dlavila/performer-hardware/sequencer.kicad_pcb

## KiCad design sequencer.kicad_pcb (2020-09-04)

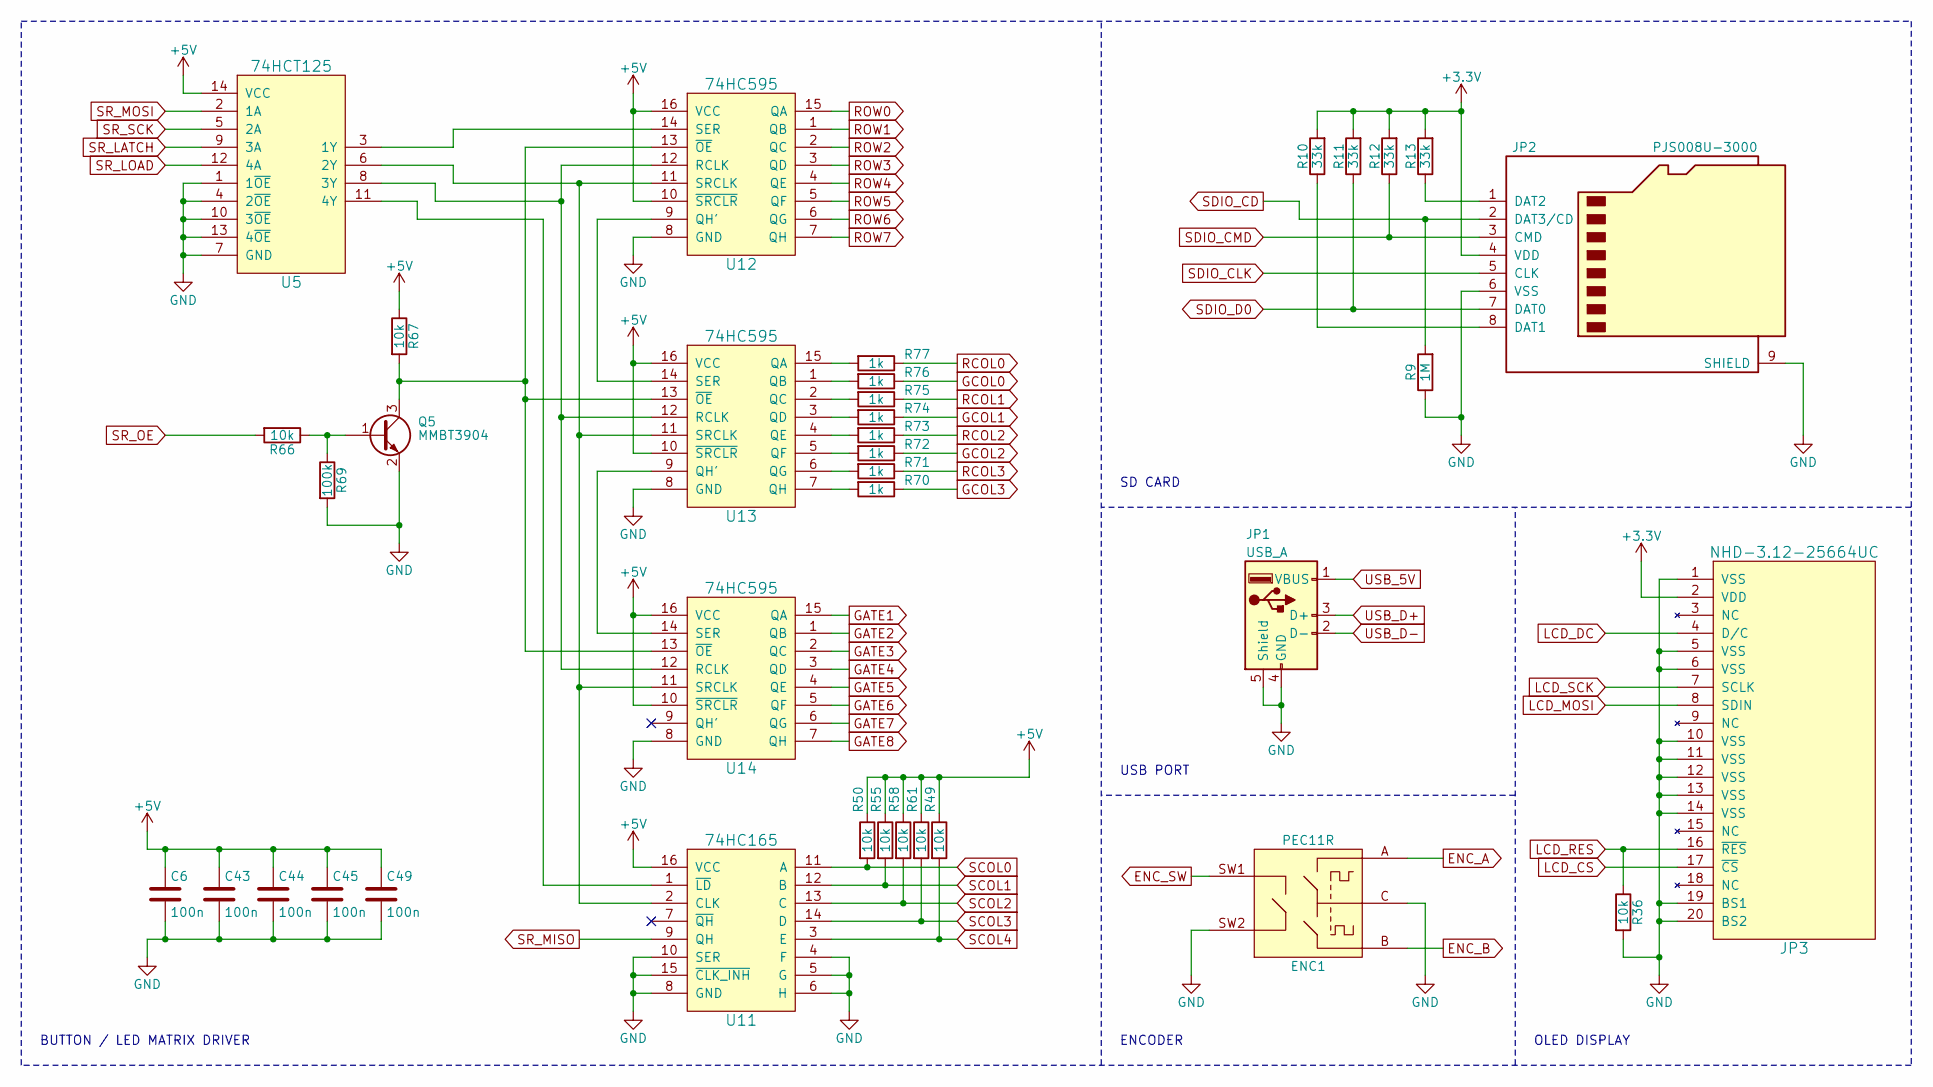
[picture p1: schematic global.sch, PER|FORMER eurorack sequencer]

Parts:
C6, C43, C44, C45, C49: 100n; C_0603
ENC1: PEC11R; ALPS_STEC12E08
JP1: USB_A; Kycon_USB_KUSBVLPX-AS1N
JP2: PJS008U-3000; PJS008U-3000-0
JP3: NHD-3.12-25664UC
Q5: MMBT3904; SOT-23
R9: 1M; R_0603
R10, R11, R12, R13: 33k; R_0603
R36, R49, R50, R55, R58, R61, R66, R67: 10k; R_0603
R69: 100k; R_0603
R70, R71, R72, R73, R74, R75, R76, R77: 1k; R_0603
U5: 74HCT125; SOIC-14_3.9x8.7mm_P1.27mm
U11: 74HC165; SOIC-16
U12, U13, U14: 74HC595; SOIC-16

Connections:
ENC_A: ENC1.A; also elsewhere on the board
ENC_B: ENC1.B; also elsewhere on the board
ENC_SW: ENC1.SW1; also elsewhere on the board
GATE1: U14.15 (QA); also elsewhere on the board
GATE2: U14.1 (QB); also elsewhere on the board
GATE3: U14.2 (QC); also elsewhere on the board
GATE4: U14.3 (QD); also elsewhere on the board
GATE5: U14.4 (QE); also elsewhere on the board
GATE6: U14.5 (QF); also elsewhere on the board
GATE7: U14.6 (QG); also elsewhere on the board
GATE8: U14.7 (QH); also elsewhere on the board
GCOL0: R76.1; also elsewhere on the board
GCOL1: R74.1; also elsewhere on the board
GCOL2: R72.1; also elsewhere on the board
GCOL3: R70.1; also elsewhere on the board
LCD_CS: JP3.17 (~CS); also elsewhere on the board
LCD_DC: JP3.4 (D/C); also elsewhere on the board
LCD_MOSI: JP3.8 (SDIN); also elsewhere on the board
LCD_RES: JP3.16 (~RES), R36.1; also elsewhere on the board
LCD_SCK: JP3.7 (SCLK); also elsewhere on the board
unnamed: JP2.1 (DAT2), R13.1
unnamed: JP2.8 (DAT1), R10.1
unnamed: Q5.1 (B), R66.1, R69.1
unnamed: Q5.3 (C), R67.2, U12.13 (~OE~), U13.13 (~OE~), U14.13 (~OE~)
unnamed: R70.2, U13.7 (QH)
unnamed: R71.2, U13.6 (QG)
unnamed: R72.2, U13.5 (QF)
unnamed: R73.2, U13.4 (QE)
unnamed: R74.2, U13.3 (QD)
unnamed: R75.2, U13.2 (QC)
unnamed: R76.2, U13.1 (QB)
unnamed: R77.2, U13.15 (QA)
unnamed: U5.11 (4Y), U11.1 (~LD~)
unnamed: U5.6 (2Y), U11.2 (CLK), U12.11 (SRCLK), U13.11 (SRCLK), U14.11 (SRCLK)
unnamed: U12.9 (QH'), U13.14 (SER)
unnamed: U5.8 (3Y), U12.12 (RCLK), U13.12 (RCLK), U14.12 (RCLK)
unnamed: U5.3 (1Y), U12.14 (SER)
unnamed: U13.9 (QH'), U14.14 (SER)
RCOL0: R77.1; also elsewhere on the board
RCOL1: R75.1; also elsewhere on the board
RCOL2: R73.1; also elsewhere on the board
RCOL3: R71.1; also elsewhere on the board
ROW0: U12.15 (QA); also elsewhere on the board
ROW1: U12.1 (QB); also elsewhere on the board
ROW2: U12.2 (QC); also elsewhere on the board
ROW3: U12.3 (QD); also elsewhere on the board
ROW4: U12.4 (QE); also elsewhere on the board
ROW5: U12.5 (QF); also elsewhere on the board
ROW6: U12.6 (QG); also elsewhere on the board
ROW7: U12.7 (QH); also elsewhere on the board
SCOL0: R50.2, U11.11 (A); also elsewhere on the board
SCOL1: R55.2, U11.12 (B); also elsewhere on the board
SCOL2: R58.2, U11.13 (C); also elsewhere on the board
SCOL3: R61.2, U11.14 (D); also elsewhere on the board
SCOL4: R49.2, U11.3 (E); also elsewhere on the board
SDIO_CD: JP2.2 (DAT3/CD), R9.2; also elsewhere on the board
SDIO_CLK: JP2.5 (CLK); also elsewhere on the board
SDIO_CMD: JP2.3 (CMD), R12.1; also elsewhere on the board
SDIO_D0: JP2.7 (DAT0), R11.1; also elsewhere on the board
SR_LATCH: U5.9 (3A); also elsewhere on the board
SR_LOAD: U5.12 (4A); also elsewhere on the board
SR_MISO: U11.9 (QH); also elsewhere on the board
SR_MOSI: U5.2 (1A); also elsewhere on the board
SR_OE: R66.2; also elsewhere on the board
SR_SCK: U5.5 (2A); also elsewhere on the board
USB_5V: JP1.1 (VBUS); also elsewhere on the board
USB_D+: JP1.3 (D+); also elsewhere on the board
USB_D-: JP1.2 (D-); also elsewhere on the board

Notes on the sheet:
BUTTON / LED MATRIX DRIVER
SD CARD
OLED DISPLAY
ENCODER
USB PORT

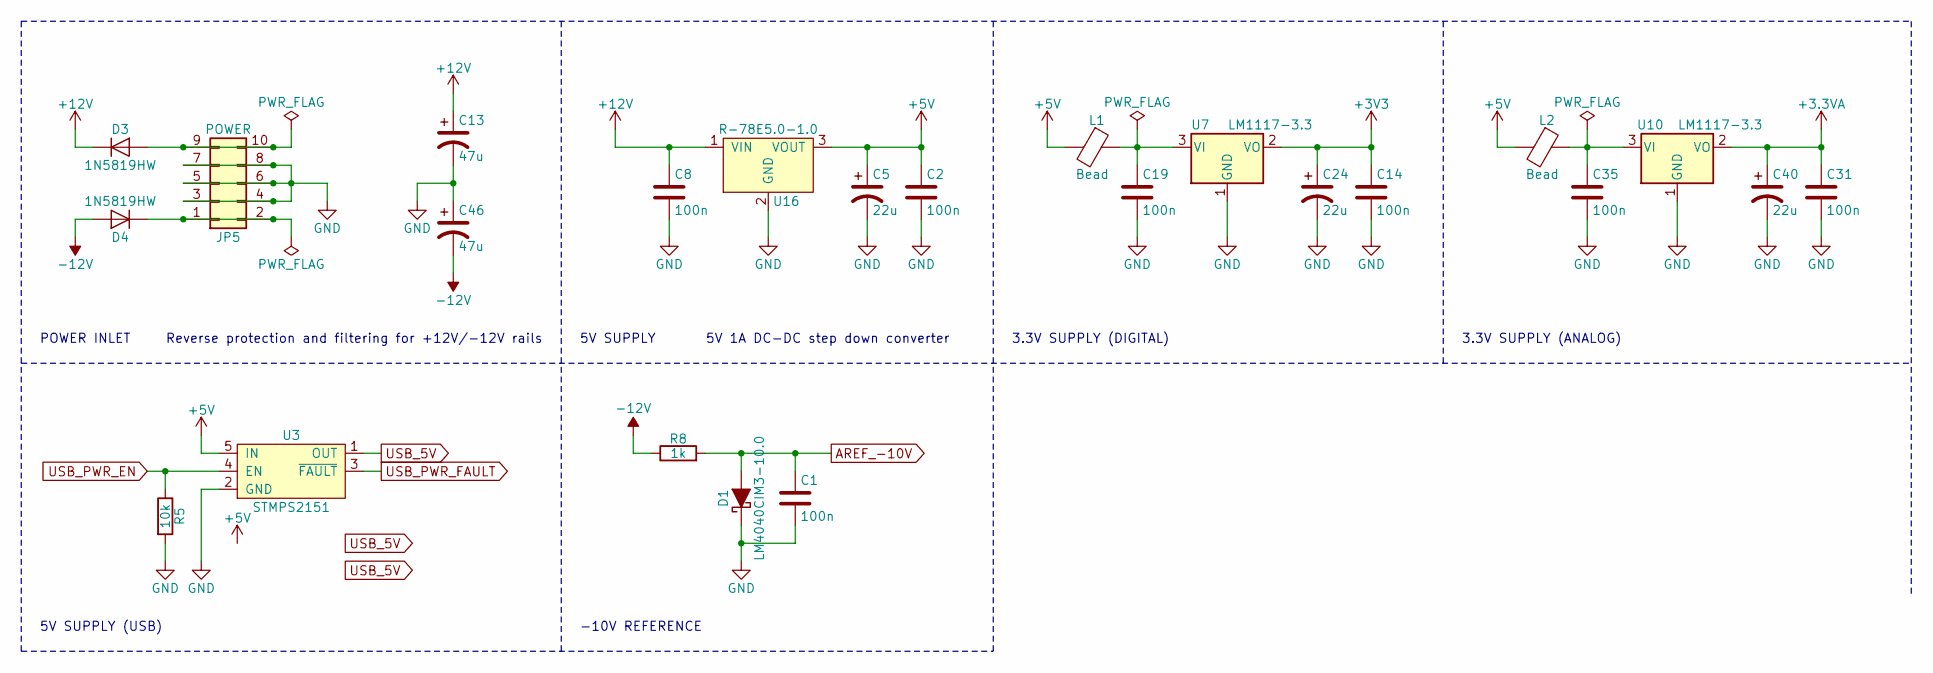
[picture p2: schematic power.sch, PER|FORMER eurorack sequencer]

Parts:
C1, C2, C8, C14, C19, C31, C35: 100n; C_0603
C5, C24, C40: 22u; CP_Elec_5x5.8
C13, C46: 47u; CP_Elec_6.3x5.7
D1: LM4040CIM3-10.0; SOT-23
D3, D4: 1N5819HW; D_SOD-123
JP5: POWER; PinHeader_2x05_P2.54mm_Vertical
L1, L2: Bead; R_0603
R5: 10k; R_0603
R8: 1k; R_0603
U3: STMPS2151; TSSOP-8_4.4x3mm_P0.65mm
U7, U10: LM1117-3.3; SOT-223-3_TabPin2
U16: R-78E5.0-1.0; R-78E-1.0

Connections:
+3.3VA: C31.1, C40.1, U10.2 (VO); also elsewhere on the board
+12V: C8.1, C13.1, D3.1 (K), U16.1 (VIN); also elsewhere on the board
-12V: C46.2, D4.2 (A), R8.1; also elsewhere on the board
AREF_-10V: C1.1, D1.2 (A), R8.2; also elsewhere on the board
unnamed: C19.1, L1.1, U7.3 (VI)
unnamed: C35.1, L2.1, U10.3 (VI)
unnamed: D3.2 (A), JP5.9, JP5.10
unnamed: D4.1 (K), JP5.1, JP5.2
USB_5V: U3.6, U3.7, U3.8; also elsewhere on the board
USB_PWR_EN: R5.1, U3.4 (EN); also elsewhere on the board

Notes on the sheet:
POWER INLET
Reverse protection and filtering for +12V/-12V rails
5V SUPPLY
5V 1A DC-DC step down converter
3.3V SUPPLY (DIGITAL)
3.3V SUPPLY (ANALOG)
5V SUPPLY (USB)
-10V REFERENCE

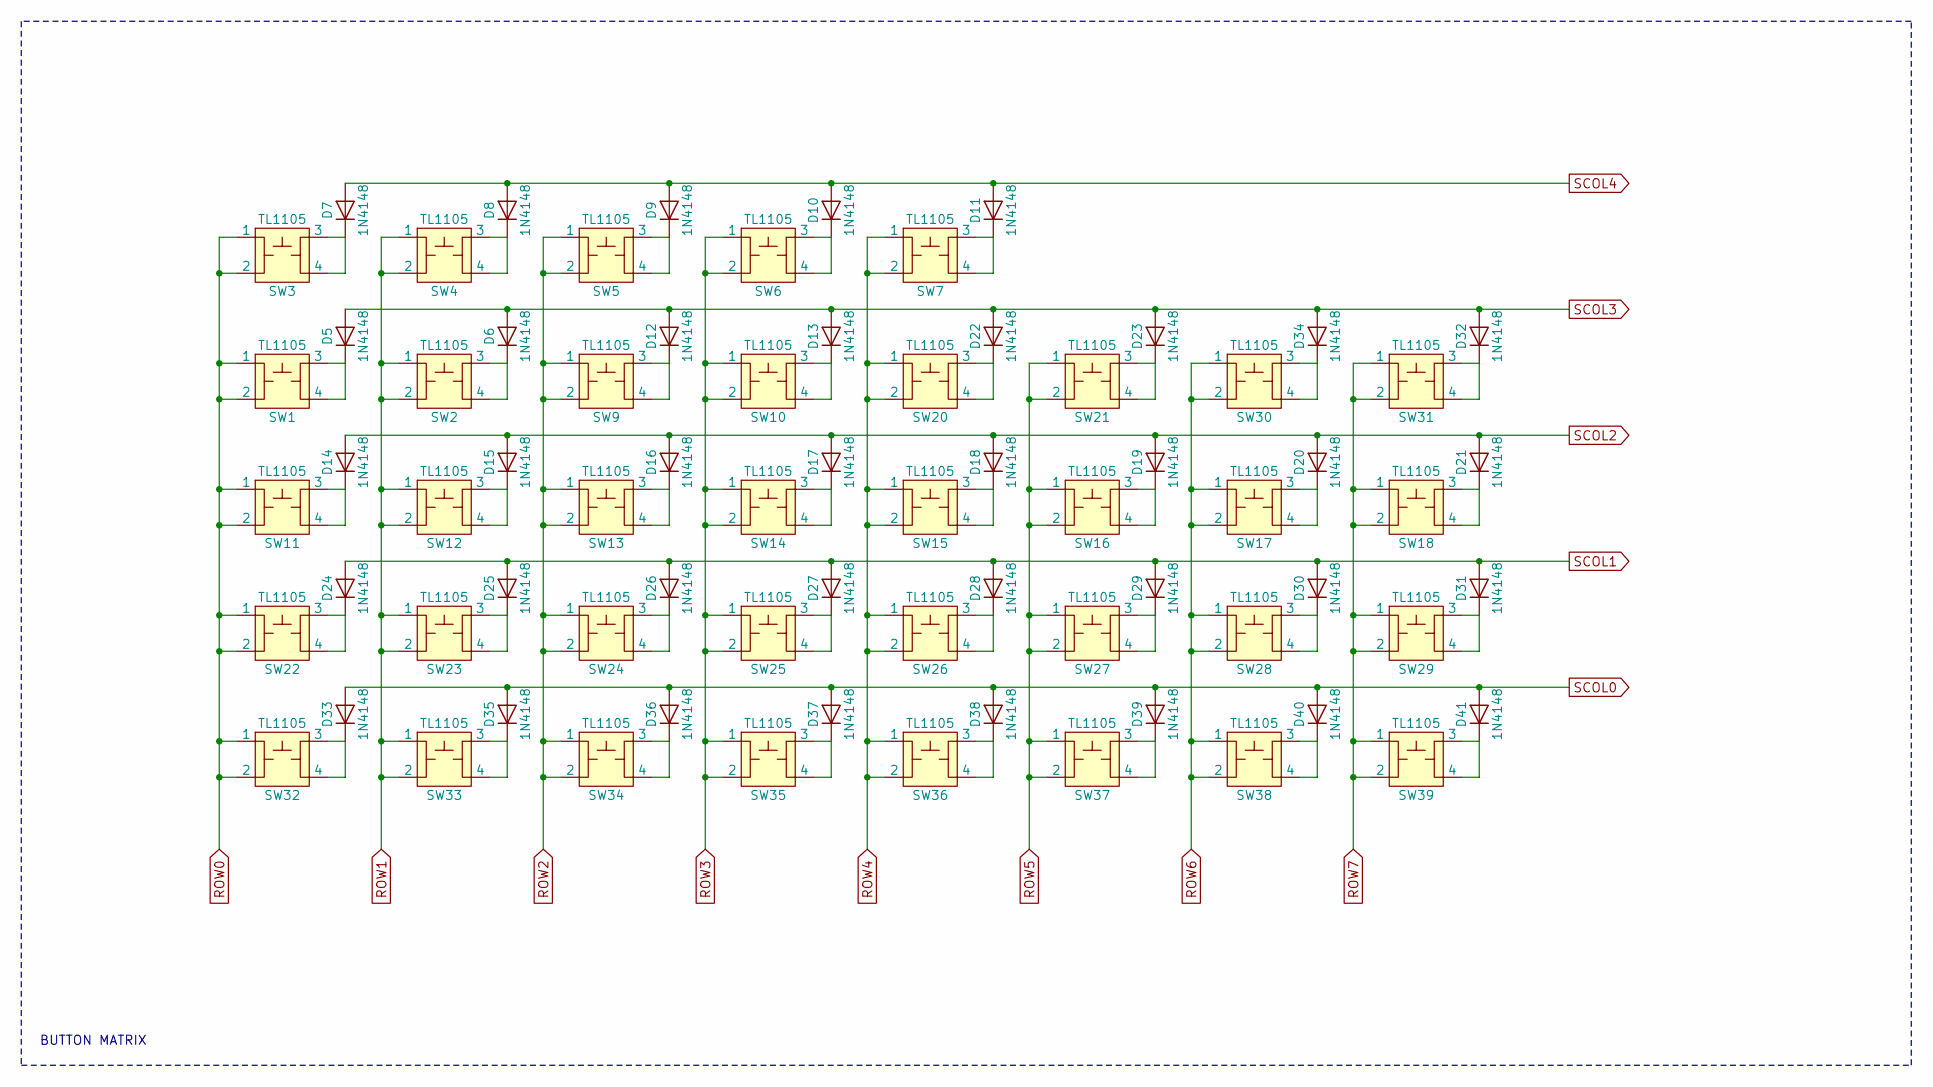
[picture p3: schematic button-matrix.sch, PER|FORMER eurorack sequencer]

Parts:
D5, D6, D7, D8, D9, D10, D11, D12, D13, D14, D15, D16, D17, D18, D19, D20, D21, D22, D23, D24, D25, D26, D27, D28, D29, D30, D31, D32, D33, D34, D35, D36, D37, D38, D39, D40, D41: 1N4148; D_SOD-123
SW1, SW2, SW3, SW4, SW5, SW6, SW7, SW9, SW10, SW11, SW12, SW13, SW14, SW15, SW16, SW17, SW18, SW20, SW21, SW22, SW23, SW24, SW25, SW26, SW27, SW28, SW29, SW30, SW31, SW32, SW33, SW34, SW35, SW36, SW37, SW38, SW39: TL1105; TL1105T

Connections:
unnamed: D5.1 (K), SW1.3, SW1.4
unnamed: D6.1 (K), SW2.3, SW2.4
unnamed: D7.1 (K), SW3.3, SW3.4
unnamed: D8.1 (K), SW4.3, SW4.4
unnamed: D9.1 (K), SW5.3, SW5.4
unnamed: D10.1 (K), SW6.3, SW6.4
unnamed: D11.1 (K), SW7.3, SW7.4
unnamed: D12.1 (K), SW9.3, SW9.4
unnamed: D13.1 (K), SW10.3, SW10.4
unnamed: D14.1 (K), SW11.3, SW11.4
unnamed: D15.1 (K), SW12.3, SW12.4
unnamed: D16.1 (K), SW13.3, SW13.4
unnamed: D17.1 (K), SW14.3, SW14.4
unnamed: D18.1 (K), SW15.3, SW15.4
unnamed: D19.1 (K), SW16.3, SW16.4
unnamed: D20.1 (K), SW17.3, SW17.4
unnamed: D21.1 (K), SW18.3, SW18.4
unnamed: D22.1 (K), SW20.3, SW20.4
unnamed: D23.1 (K), SW21.3, SW21.4
unnamed: D24.1 (K), SW22.3, SW22.4
unnamed: D25.1 (K), SW23.3, SW23.4
unnamed: D26.1 (K), SW24.3, SW24.4
unnamed: D27.1 (K), SW25.3, SW25.4
unnamed: D28.1 (K), SW26.3, SW26.4
unnamed: D29.1 (K), SW27.3, SW27.4
unnamed: D30.1 (K), SW28.3, SW28.4
unnamed: D31.1 (K), SW29.3, SW29.4
unnamed: D32.1 (K), SW31.3, SW31.4
unnamed: D33.1 (K), SW32.3, SW32.4
unnamed: D34.1 (K), SW30.3, SW30.4
unnamed: D35.1 (K), SW33.3, SW33.4
unnamed: D36.1 (K), SW34.3, SW34.4
unnamed: D37.1 (K), SW35.3, SW35.4
unnamed: D38.1 (K), SW36.3, SW36.4
unnamed: D39.1 (K), SW37.3, SW37.4
unnamed: D40.1 (K), SW38.3, SW38.4
unnamed: D41.1 (K), SW39.3, SW39.4
ROW0: SW1.1, SW1.2, SW3.1, SW3.2, SW11.1, SW11.2, SW22.1, SW22.2, SW32.1, SW32.2; also elsewhere on the board
ROW1: SW2.1, SW2.2, SW4.1, SW4.2, SW12.1, SW12.2, SW23.1, SW23.2, SW33.1, SW33.2; also elsewhere on the board
ROW2: SW5.1, SW5.2, SW9.1, SW9.2, SW13.1, SW13.2, SW24.1, SW24.2, SW34.1, SW34.2; also elsewhere on the board
ROW3: SW6.1, SW6.2, SW10.1, SW10.2, SW14.1, SW14.2, SW25.1, SW25.2, SW35.1, SW35.2; also elsewhere on the board
ROW4: SW7.1, SW7.2, SW15.1, SW15.2, SW20.1, SW20.2, SW26.1, SW26.2, SW36.1, SW36.2; also elsewhere on the board
ROW5: SW16.1, SW16.2, SW21.1, SW21.2, SW27.1, SW27.2, SW37.1, SW37.2; also elsewhere on the board
ROW6: SW17.1, SW17.2, SW28.1, SW28.2, SW30.1, SW30.2, SW38.1, SW38.2; also elsewhere on the board
ROW7: SW18.1, SW18.2, SW29.1, SW29.2, SW31.1, SW31.2, SW39.1, SW39.2; also elsewhere on the board
SCOL0: D33.2 (A), D35.2 (A), D36.2 (A), D37.2 (A), D38.2 (A), D39.2 (A), D40.2 (A), D41.2 (A); also elsewhere on the board
SCOL1: D24.2 (A), D25.2 (A), D26.2 (A), D27.2 (A), D28.2 (A), D29.2 (A), D30.2 (A), D31.2 (A); also elsewhere on the board
SCOL2: D14.2 (A), D15.2 (A), D16.2 (A), D17.2 (A), D18.2 (A), D19.2 (A), D20.2 (A), D21.2 (A); also elsewhere on the board
SCOL3: D5.2 (A), D6.2 (A), D12.2 (A), D13.2 (A), D22.2 (A), D23.2 (A), D32.2 (A), D34.2 (A); also elsewhere on the board
SCOL4: D7.2 (A), D8.2 (A), D9.2 (A), D10.2 (A), D11.2 (A); also elsewhere on the board

Notes on the sheet:
BUTTON MATRIX

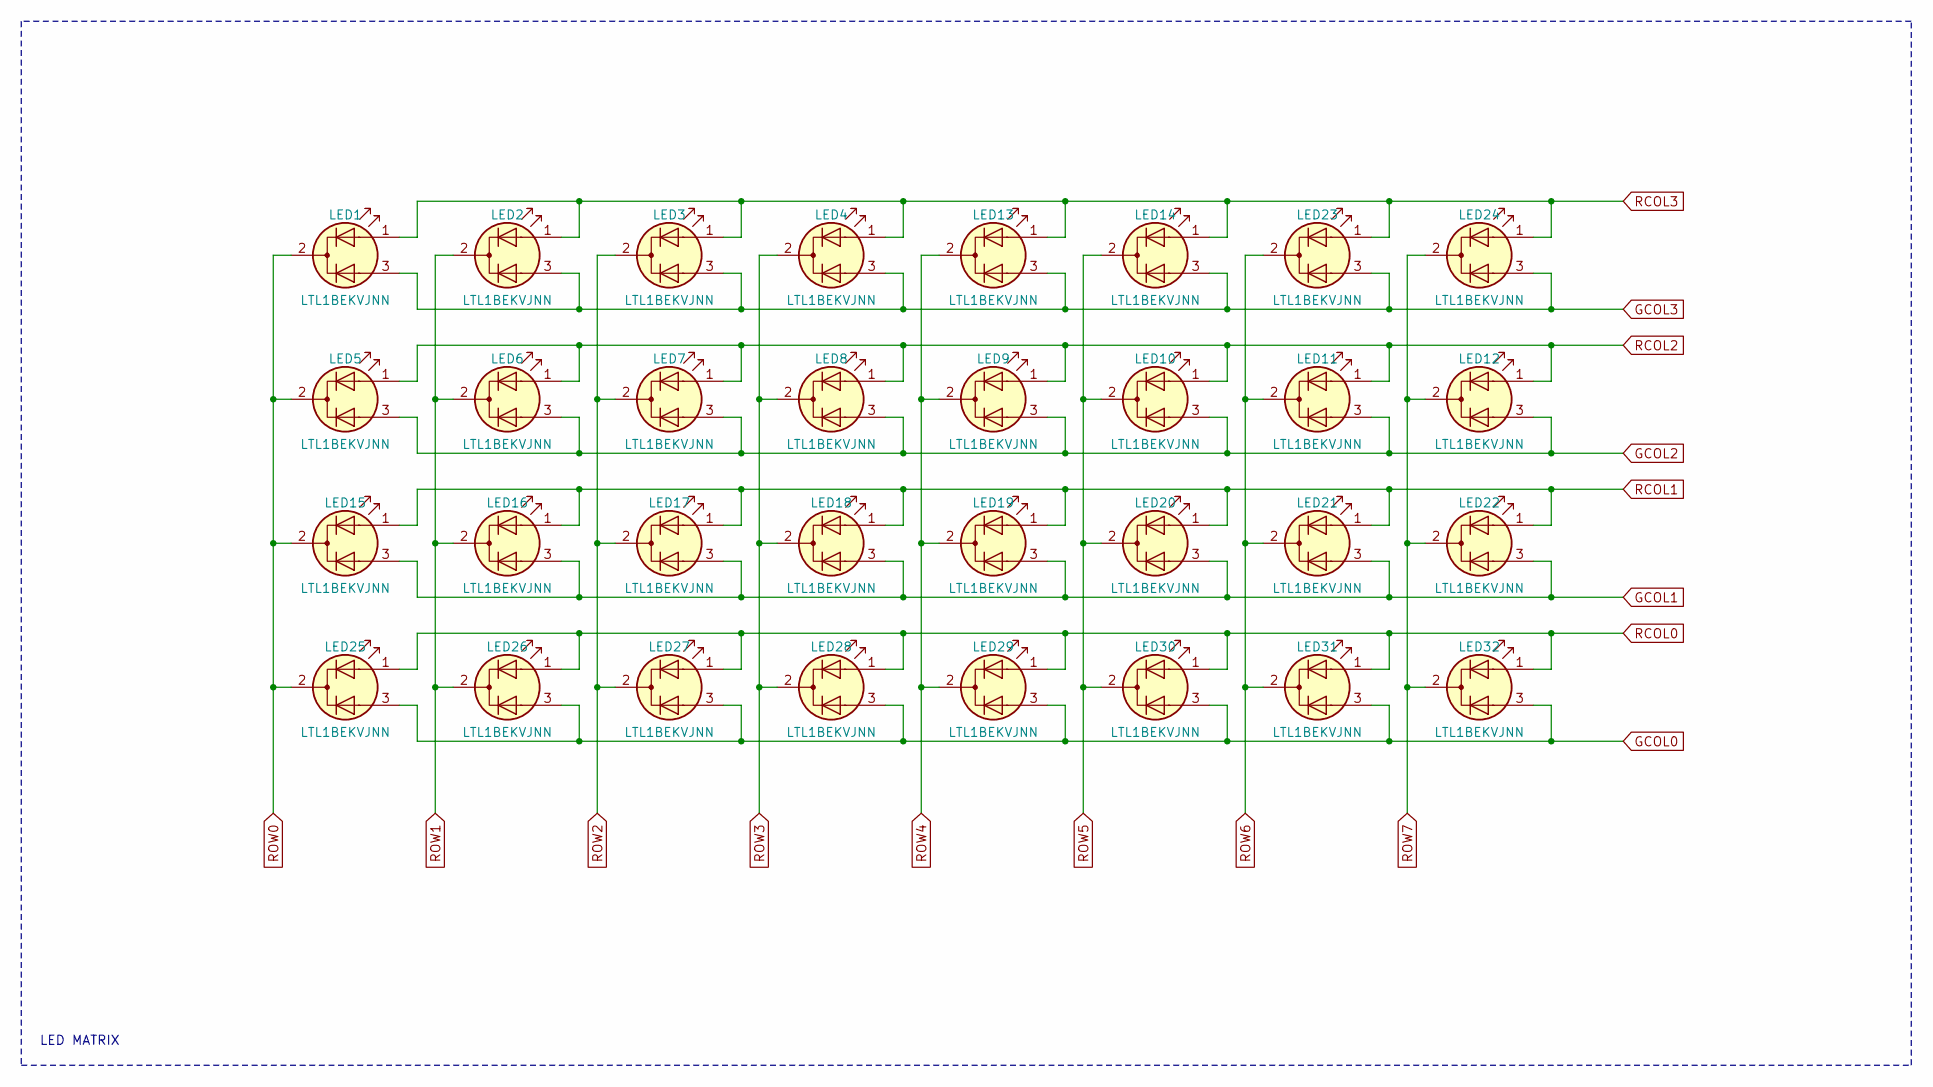
[picture p4: schematic led-matrix.sch, PER|FORMER eurorack sequencer]

Parts:
LED1, LED2, LED3, LED4, LED5, LED6, LED7, LED8, LED9, LED10, LED11, LED12, LED13, LED14, LED15, LED16, LED17, LED18, LED19, LED20, LED21, LED22, LED23, LED24, LED25, LED26, LED27, LED28, LED29, LED30, LED31, LED32: LTL1BEKVJNN

Connections:
GCOL0: LED25.3 (A2), LED26.3 (A2), LED27.3 (A2), LED28.3 (A2), LED29.3 (A2), LED30.3 (A2), LED31.3 (A2), LED32.3 (A2); also elsewhere on the board
GCOL1: LED15.3 (A2), LED16.3 (A2), LED17.3 (A2), LED18.3 (A2), LED19.3 (A2), LED20.3 (A2), LED21.3 (A2), LED22.3 (A2); also elsewhere on the board
GCOL2: LED5.3 (A2), LED6.3 (A2), LED7.3 (A2), LED8.3 (A2), LED9.3 (A2), LED10.3 (A2), LED11.3 (A2), LED12.3 (A2); also elsewhere on the board
GCOL3: LED1.3 (A2), LED2.3 (A2), LED3.3 (A2), LED4.3 (A2), LED13.3 (A2), LED14.3 (A2), LED23.3 (A2), LED24.3 (A2); also elsewhere on the board
RCOL0: LED25.1 (A1), LED26.1 (A1), LED27.1 (A1), LED28.1 (A1), LED29.1 (A1), LED30.1 (A1), LED31.1 (A1), LED32.1 (A1); also elsewhere on the board
RCOL1: LED15.1 (A1), LED16.1 (A1), LED17.1 (A1), LED18.1 (A1), LED19.1 (A1), LED20.1 (A1), LED21.1 (A1), LED22.1 (A1); also elsewhere on the board
RCOL2: LED5.1 (A1), LED6.1 (A1), LED7.1 (A1), LED8.1 (A1), LED9.1 (A1), LED10.1 (A1), LED11.1 (A1), LED12.1 (A1); also elsewhere on the board
RCOL3: LED1.1 (A1), LED2.1 (A1), LED3.1 (A1), LED4.1 (A1), LED13.1 (A1), LED14.1 (A1), LED23.1 (A1), LED24.1 (A1); also elsewhere on the board
ROW0: LED1.2 (K), LED5.2 (K), LED15.2 (K), LED25.2 (K); also elsewhere on the board
ROW1: LED2.2 (K), LED6.2 (K), LED16.2 (K), LED26.2 (K); also elsewhere on the board
ROW2: LED3.2 (K), LED7.2 (K), LED17.2 (K), LED27.2 (K); also elsewhere on the board
ROW3: LED4.2 (K), LED8.2 (K), LED18.2 (K), LED28.2 (K); also elsewhere on the board
ROW4: LED9.2 (K), LED13.2 (K), LED19.2 (K), LED29.2 (K); also elsewhere on the board
ROW5: LED10.2 (K), LED14.2 (K), LED20.2 (K), LED30.2 (K); also elsewhere on the board
ROW6: LED11.2 (K), LED21.2 (K), LED23.2 (K), LED31.2 (K); also elsewhere on the board
ROW7: LED12.2 (K), LED22.2 (K), LED24.2 (K), LED32.2 (K); also elsewhere on the board

Notes on the sheet:
LED MATRIX

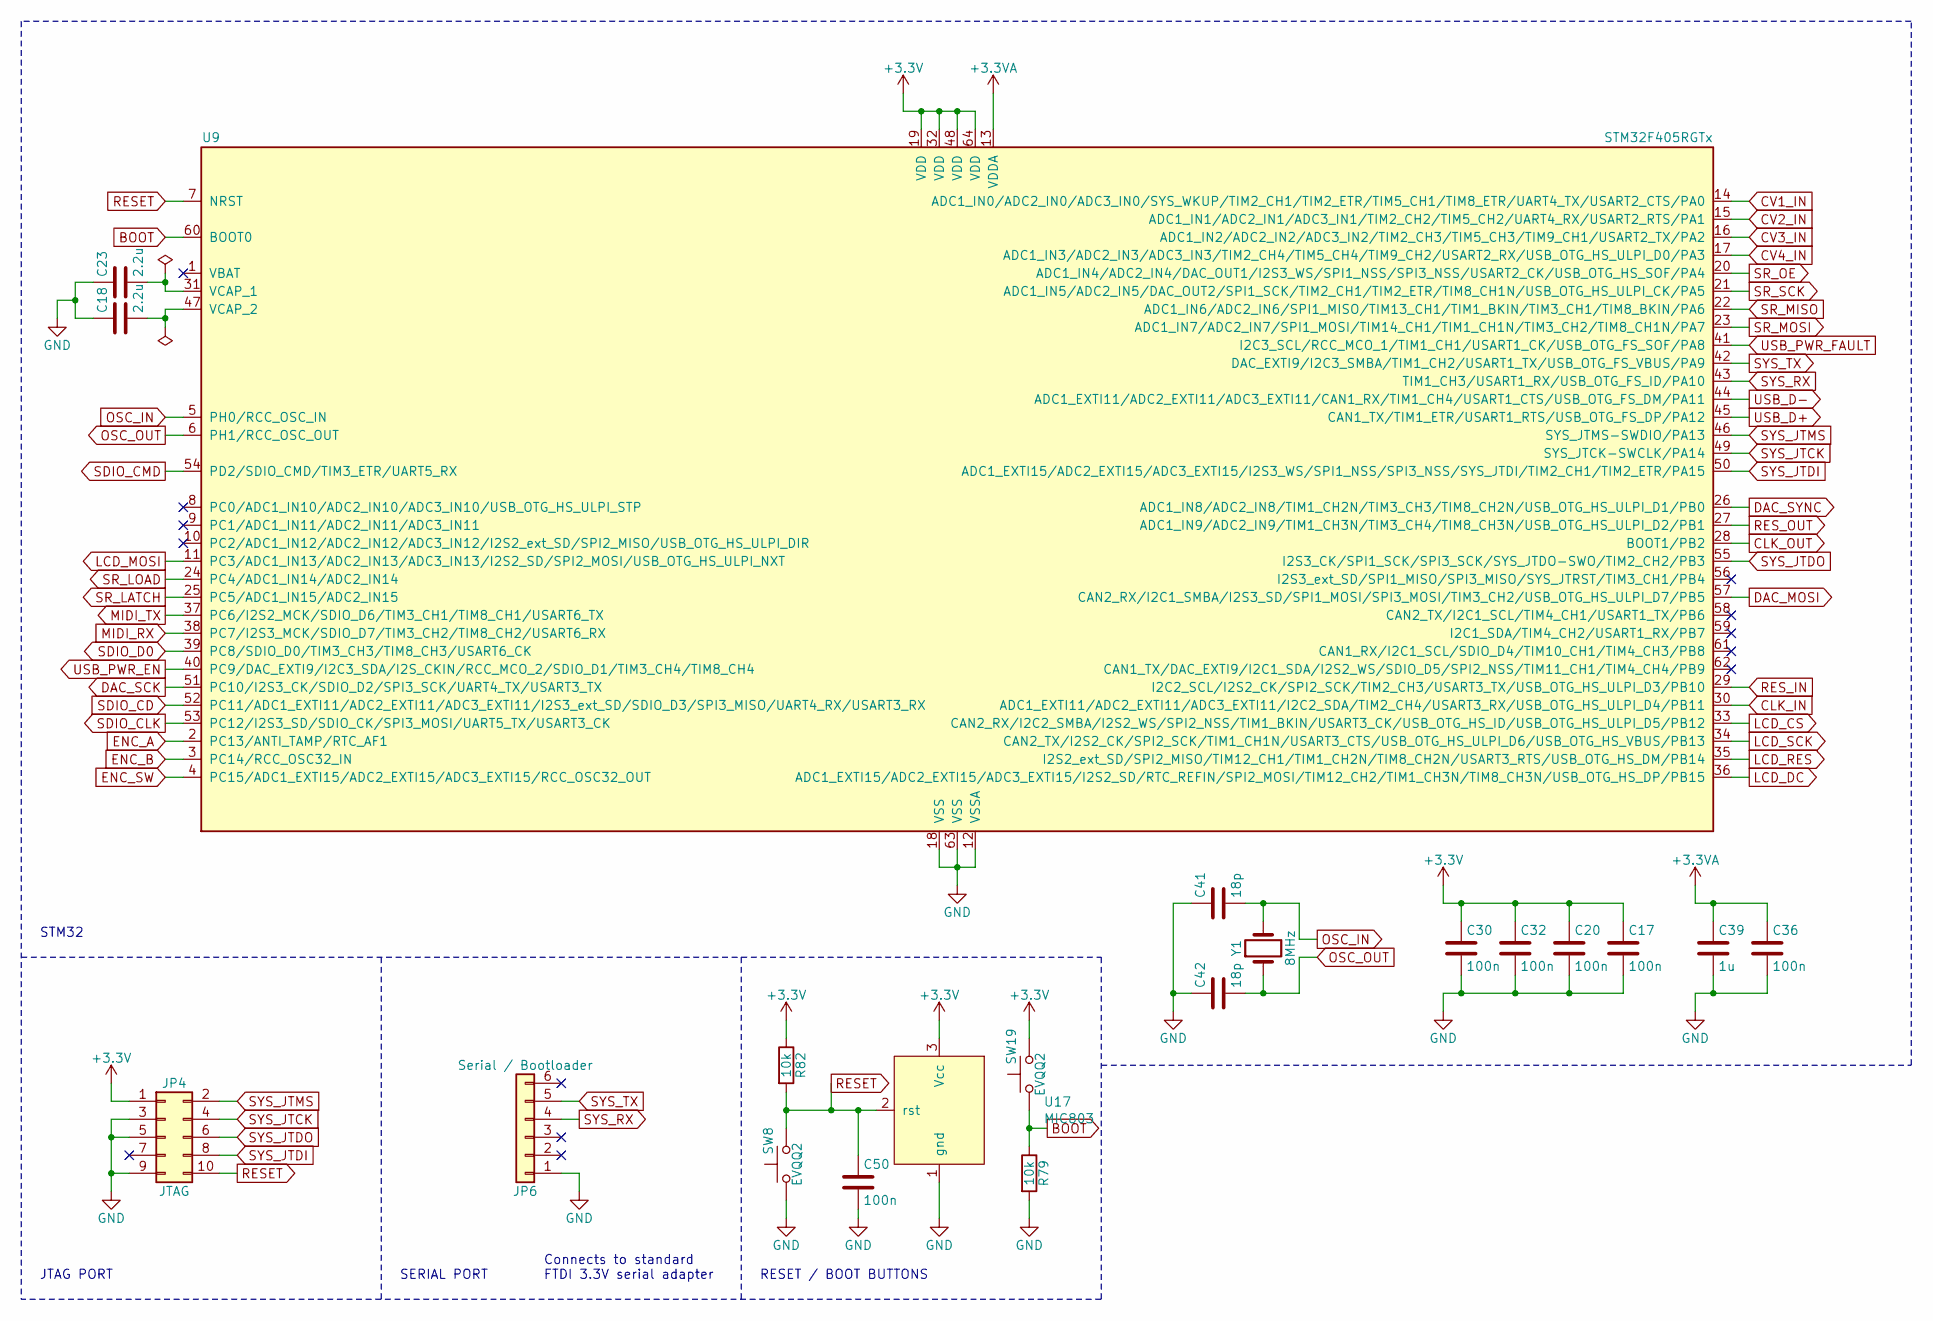
[picture p5: schematic mcu.sch, PER|FORMER eurorack sequencer]

Parts:
C17, C20, C30, C32, C36, C50: 100n; C_0603
C18, C23: 2.2u; C_0603
C39: 1u; C_0603
C41, C42: 18p; C_0603
JP4: JTAG; PinHeader_2x05_P1.27mm_Vertical
JP6: Serial / Bootloader; PinHeader_1x06_P2.54mm_Vertical
R79, R82: 10k; R_0603
SW8, SW19: EVQQ2; SW_SPST_EVQQ2
U9: STM32F405RGTx; LQFP-64_10x10mm_P0.5mm
U17: MIC803; SOT-23
Y1: 8MHz; Crystal_SMD_Abracon_ABM3-2Pin_5.0x3.2mm_HandSoldering

Connections:
+3.3VA: C36.1, C39.1, U9.13 (VDDA); also elsewhere on the board
BOOT: R79.1, SW19.1, U9.60 (BOOT0)
CLK_IN: U9.30 (ADC1_EXTI11/ADC2_EXTI11/ADC3_EXTI11/I2C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); also elsewhere on the board
CLK_OUT: U9.28 (BOOT1/PB2); also elsewhere on the board
CV1_IN: U9.14 (ADC1_IN0/ADC2_IN0/ADC3_IN0/SYS_WKUP/TIM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); also elsewhere on the board
CV2_IN: U9.15 (ADC1_IN1/ADC2_IN1/ADC3_IN1/TIM2_CH2/TIM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); also elsewhere on the board
CV3_IN: U9.16 (ADC1_IN2/ADC2_IN2/ADC3_IN2/TIM2_CH3/TIM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); also elsewhere on the board
CV4_IN: U9.17 (ADC1_IN3/ADC2_IN3/ADC3_IN3/TIM2_CH4/TIM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); also elsewhere on the board
DAC_MOSI: U9.57 (CAN2_RX/I2C1_SMBA/I2S3_SD/SPI1_MOSI/SPI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); also elsewhere on the board
DAC_SCK: U9.51 (PC10/I2S3_CK/SDIO_D2/SPI3_SCK/UART4_TX/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); also elsewhere on the board
DAC_SYNC: U9.26 (ADC1_IN8/ADC2_IN8/TIM1_CH2N/TIM3_CH3/TI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); also elsewhere on the board
ENC_A: U9.2 (PC13/ANTI_TAMP/RTC_AF1); also elsewhere on the board
ENC_B: U9.3 (PC14/RCC_OSC32_IN); also elsewhere on the board
ENC_SW: U9.4 (PC15/ADC1_EXTI15/ADC2_EXTI15/ADC3_EXTI1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); also elsewhere on the board
LCD_CS: U9.33 (CAN2_RX/I2C2_SMBA/I2S2_WS/SPI2_NSS/TIM1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); also elsewhere on the board
LCD_DC: U9.36 (ADC1_EXTI15/ADC2_EXTI15/ADC3_EXTI15/I2S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); also elsewhere on the board
LCD_MOSI: U9.11 (PC3/ADC1_IN13/ADC2_IN13/ADC3_IN13/I2S2_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); also elsewhere on the board
LCD_RES: U9.35 (I2S2_ext_SD/SPI2_MISO/TIM12_CH1/TIM1_CH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); also elsewhere on the board
LCD_SCK: U9.34 (CAN2_TX/I2S2_CK/SPI2_SCK/TIM1_CH1N/USAR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); also elsewhere on the board
MIDI_RX: U9.38 (PC7/I2S3_MCK/SDIO_D7/TIM3_CH2/TIM8_CH2/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); also elsewhere on the board
MIDI_TX: U9.37 (PC6/I2S2_MCK/SDIO_D6/TIM3_CH1/TIM8_CH1/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); also elsewhere on the board
unnamed: C18.2, U9.47 (VCAP_2)
unnamed: C23.2, U9.31 (VCAP_1)
OSC_IN: C41.2, U9.5 (PH0/RCC_OSC_IN), Y1.2
OSC_OUT: C42.2, U9.6 (PH1/RCC_OSC_OUT), Y1.1
RESET: C50.1, JP4.10, R82.2, SW8.2, U9.7 (NRST), U17.2 (rst)
RES_IN: U9.29 (I2C2_SCL/I2S2_CK/SPI2_SCK/TIM2_CH3/USAR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); also elsewhere on the board
RES_OUT: U9.27 (ADC1_IN9/ADC2_IN9/TIM1_CH3N/TIM3_CH4/TI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); also elsewhere on the board
SDIO_CD: U9.52 (PC11/ADC1_EXTI11/ADC2_EXTI11/ADC3_EXTI1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); also elsewhere on the board
SDIO_CLK: U9.53 (PC12/I2S3_SD/SDIO_CK/SPI3_MOSI/UART5_TX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); also elsewhere on the board
SDIO_CMD: U9.54 (PD2/SDIO_CMD/TIM3_ETR/UART5_RX); also elsewhere on the board
SDIO_D0: U9.39 (PC8/SDIO_D0/TIM3_CH3/TIM8_CH3/USART6_CK); also elsewhere on the board
SR_LATCH: U9.25 (PC5/ADC1_IN15/ADC2_IN15); also elsewhere on the board
SR_LOAD: U9.24 (PC4/ADC1_IN14/ADC2_IN14); also elsewhere on the board
SR_MISO: U9.22 (ADC1_IN6/ADC2_IN6/SPI1_MISO/TIM13_CH1/T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); also elsewhere on the board
SR_MOSI: U9.23 (ADC1_IN7/ADC2_IN7/SPI1_MOSI/TIM14_CH1/T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); also elsewhere on the board
SR_OE: U9.20 (ADC1_IN4/ADC2_IN4/DAC_OUT1/I2S3_WS/SPI1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); also elsewhere on the board
SR_SCK: U9.21 (ADC1_IN5/ADC2_IN5/DAC_OUT2/SPI1_SCK/TIM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); also elsewhere on the board
SYS_JTCK: JP4.4, U9.49 (SYS_JTCK-SWCLK/PA14)
SYS_JTDI: JP4.8, U9.50 (ADC1_EXTI15/ADC2_EXTI15/ADC3_EXTI15/I2S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)
SYS_JTDO: JP4.6, U9.55 (I2S3_CK/SPI1_SCK/SPI3_SCK/SYS_JTDO-SWO/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)
SYS_JTMS: JP4.2, U9.46 (SYS_JTMS-SWDIO/PA13)
SYS_RX: JP6.4, U9.43 (TIM1_CH3/USART1_RX/USB_OTG_FS_ID/PA10)
SYS_TX: JP6.5, U9.42 (DAC_EXTI9/I2C3_SMBA/TIM1_CH2/USART1_TX/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)
USB_D+: U9.45 (CAN1_TX/TIM1_ETR/USART1_RTS/USB_OTG_FS_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); also elsewhere on the board
USB_D-: U9.44 (ADC1_EXTI11/ADC2_EXTI11/ADC3_EXTI11/CAN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); also elsewhere on the board
USB_PWR_EN: U9.40 (PC9/DAC_EXTI9/I2C3_SDA/I2S_CKIN/RCC_MCO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); also elsewhere on the board

Notes on the sheet:
STM32
RESET / BOOT BUTTONS
SERIAL PORT
JTAG PORT
Connects to standard FTDI 3.3V serial adapter

Schematic: jacks.sch, PER|FORMER eurorack sequencer

Parts:
C7: 100n; C_0603
C9, C10, C21, C22: 1n; C_0603
C51, C52, C53, C54: ESD; C_0603
D2: 1N4148; D_SOD-123
D42, D43, D44, D45, D46, D47, D48, D49, D50, D51, D52, D53, D54, D55, D56, D57, D58, D59, D60, D61, D62, D63, D64, D65, D66, D67: LED; C_1206
D68, D69: 1N4148WS; D_SOD-123
J1, J2: PJ366ST; PJ366ST_Compact
J3, J4, J5, J6, J7, J8, J9, J10, J11, J12, J13, J14, J15, J16, J17, J18, J19, J20, J21, J22, J23, J24, J25, J26: PJ398SM; jack_thonk
J27: Conn_01x03_Female; PinHeader_1x03_P2.54mm_Vertical
Q1, Q2, Q3, Q4: MMBT3904; SOT-23
R1, R3, R4: 220; R_0603
R2, R6, R7, R19, R20: 10k; R_0603
R14, R17, R26, R27, R45, R46: 100k; R_0603
R15, R16: 1M; R_0603
R18, R21, R68, R78, R80, R81, R83, R84, R85, R86, R87, R88, R89, R90, R91, R92, R93, R94, R95, R96, R97, R98, R99, R100, R101, R102, R103, R104, R105, R106, R107, R108, R109, R110, R111, R112: 1k; R_0603
R30, R33, R37, R40: 200k; R_0603
R31, R32, R38, R39: 33k; R_0603
U1: VO0600T; SOIC-8_3.9x4.9mm_P1.27mm
U2: 74LV1T34; SOT-23-5
U6: MCP6004; SOIC-14_3.9x8.7mm_P1.27mm

Connections:
+3.3VA: C7.1, U6.4 (V+); also elsewhere on the board
+12V: J27.1; also elsewhere on the board
AREF_-10V: R30.2, R33.2, R37.2, R40.2; also elsewhere on the board
CLK_IN: Q1.3 (C), R6.2; also elsewhere on the board
CLK_OUT: R19.2; also elsewhere on the board
CV1: J12.3; also elsewhere on the board
CV1_IN: C22.1, R39.1, U6.1; also elsewhere on the board
CV2: J14.3; also elsewhere on the board
CV2_IN: C9.1, R31.1, U6.8; also elsewhere on the board
CV3: J16.3; also elsewhere on the board
CV3_IN: C10.1, R32.1, U6.7; also elsewhere on the board
CV4: J18.3; also elsewhere on the board
CV4_IN: C21.1, R38.1, U6.14; also elsewhere on the board
CV5: J20.3; also elsewhere on the board
CV6: J22.3; also elsewhere on the board
CV7: J24.3; also elsewhere on the board
CV8: J26.3; also elsewhere on the board
GATE1: R68.2; also elsewhere on the board
GATE2: R78.2; also elsewhere on the board
GATE3: R80.2; also elsewhere on the board
GATE4: R81.2; also elsewhere on the board
GATE5: R83.2; also elsewhere on the board
GATE6: R84.2; also elsewhere on the board
GATE7: R85.2; also elsewhere on the board
GATE8: R86.2; also elsewhere on the board
LED_VDD: J27.2, R87.2, R88.2, R89.2, R90.2, R91.2, R92.2, R93.2, R94.2, R95.2, R96.2, R97.2, R98.2, R99.2, R100.2, R101.2, R102.2, R103.2, R104.2, R105.2, R106.2, R107.2, R108.2, R109.2, R110.2, R111.2, R112.2
MIDI_RX: R2.2, U1.6; also elsewhere on the board
MIDI_TX: U2.2 (A); also elsewhere on the board
unnamed: C9.2, R26.1, R30.1, R31.2, U6.9 (-)
unnamed: C10.2, R27.1, R32.2, R33.1, U6.6 (-)
unnamed: C21.2, R37.1, R38.2, R45.1, U6.13 (-)
unnamed: C22.2, R39.2, R40.1, R46.1, U6.2 (-)
unnamed: C51.2, J7.3, R46.2
unnamed: C52.2, J8.3, R26.2
unnamed: C53.2, J10.3, R45.2
unnamed: C54.2, J9.3, R27.2
unnamed: D2.1 (K), R1.1, U1.2
unnamed: D2.2 (A), J1.3, U1.3
unnamed: D42.2, R87.1
unnamed: D43.2, R88.1
unnamed: D44.2, R89.1
unnamed: D45.2, R90.1
unnamed: D46.2, R91.1
unnamed: D47.2, R92.1
unnamed: D48.2, R93.1
unnamed: D49.2, R94.1
unnamed: D50.2, R95.1
unnamed: D51.2, R96.1
unnamed: D52.2, R97.1
unnamed: D53.2, R98.1
unnamed: D54.2, R99.1
unnamed: D55.2, R100.1
unnamed: D56.2, R101.1
unnamed: D57.2, R102.1
unnamed: D58.2, R103.1
unnamed: D59.2, R104.1
unnamed: D60.2, R105.1
unnamed: D61.2, R106.1
unnamed: D62.2, R107.1
unnamed: D63.2, R108.1
unnamed: D64.2, R109.1
unnamed: D65.2, R110.1
unnamed: D66.2, R111.1
unnamed: D67.2, R112.1
unnamed: D68.1, Q2.1 (B), R16.1, R17.1
unnamed: D69.1, Q1.1 (B), R14.1, R15.1
unnamed: J1.2, R1.2
unnamed: J2.2, R3.2
unnamed: J2.3, R4.2
unnamed: J3.3, R14.2
unnamed: J4.3, R17.2
unnamed: J5.3, Q3.3 (C), R18.2
unnamed: J6.3, Q4.3 (C), R21.2
unnamed: J11.3, R68.1
unnamed: J13.3, R78.1
unnamed: J15.3, R80.1
unnamed: J17.3, R81.1
unnamed: J19.3, R83.1
unnamed: J21.3, R84.1
unnamed: J23.3, R85.1
unnamed: J25.3, R86.1
unnamed: Q3.1 (B), R19.1
unnamed: Q4.1 (B), R20.1
unnamed: R4.1, U2.4 (Y)
RES_IN: Q2.3 (C), R7.2; also elsewhere on the board
RES_OUT: R20.2; also elsewhere on the board

Notes on the sheet:
CLOCK INPUTS
GATE OUTPUTS
CV OUTPUTS
MIDI INPUT/OUTPUT
CLOCK OUTPUTS
CV INPUTS
High signal threshold: 0.7V
High level: 5V
Inverting rail-to-rail opamp configuration, Input range [-5V,5V], Output range [3.3V,0V]
