dlavila/performer-hardware/sequencer.kicad_pcb

## KiCad design sequencer.kicad_pcb (continued)

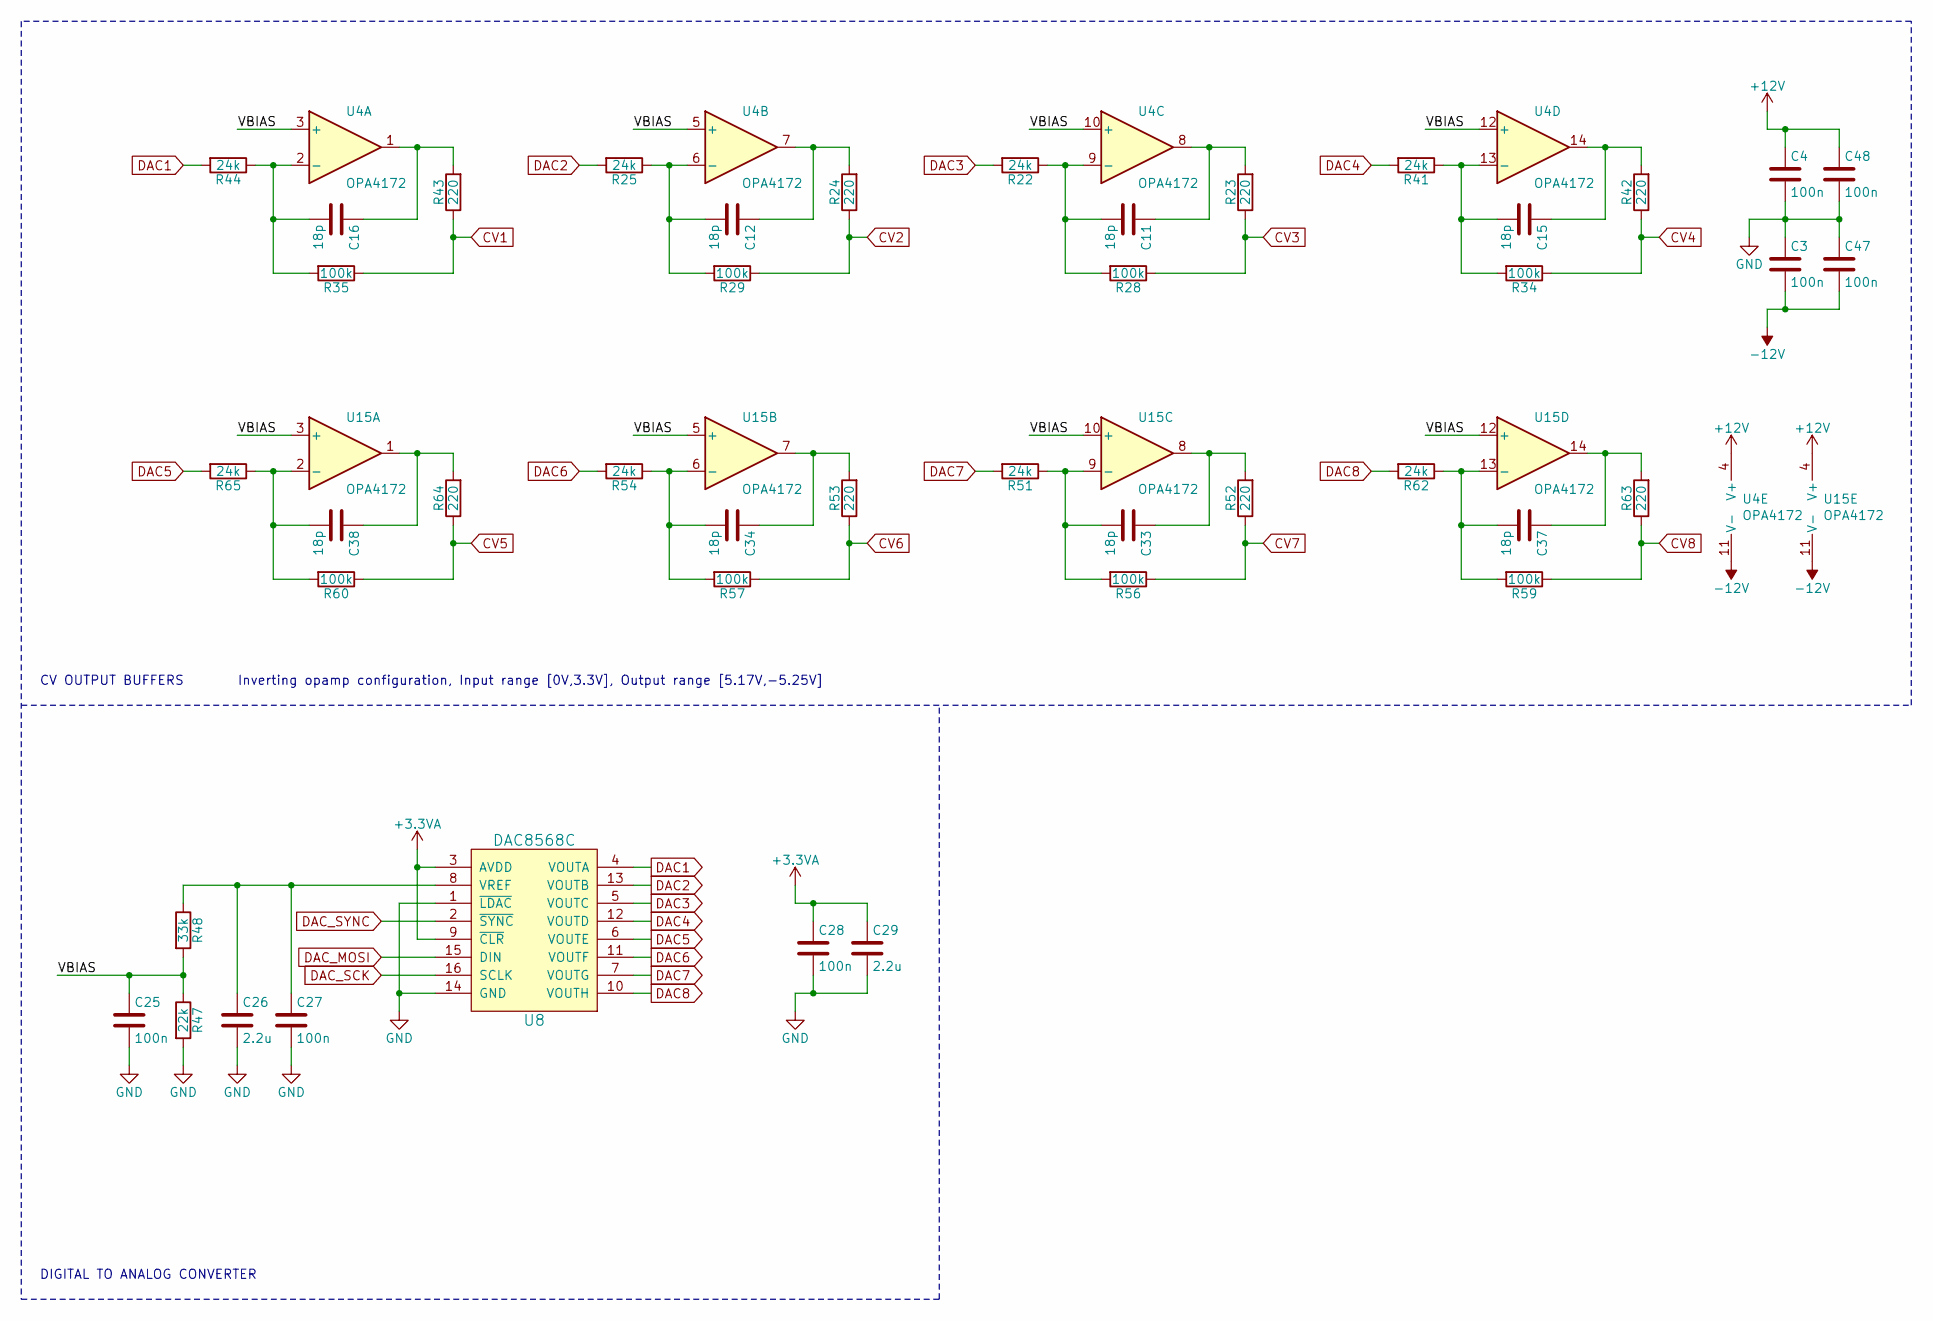
[picture p6: schematic dac.sch, PER|FORMER eurorack sequencer]

Parts:
C3, C4, C25, C27, C28, C47, C48: 100n; C_0603
C11, C12, C15, C16, C33, C34, C37, C38: 18p; C_0603
C26, C29: 2.2u; C_0603
R22, R25, R41, R44, R51, R54, R62, R65: 24k; R_0603
R23, R24, R42, R43, R52, R53, R63, R64: 220; R_0603
R28, R29, R34, R35, R56, R57, R59, R60: 100k; R_0603
R47: 22k; R_0603
R48: 33k; R_0603
U4, U15: OPA4172; SOIC-14_3.9x8.7mm_P1.27mm
U8: DAC8568C; TSSOP-16_4.4x5mm_P0.65mm

Connections:
+3.3VA: C28.1, C29.1, U8.3 (AVDD), U8.9 (~CLR); also elsewhere on the board
+12V: C4.1, C48.1, U4.4 (V+), U15.4 (V+); also elsewhere on the board
-12V: C3.2, C47.2, U4.11 (V-), U15.11 (V-); also elsewhere on the board
/DAC/VBIAS: C25.1, R47.1, R48.2, U4.3 (+), U4.5 (+), U4.10 (+), U4.12 (+), U15.3 (+), U15.5 (+), U15.10 (+), U15.12 (+)
CV1: R35.1, R43.1; also elsewhere on the board
CV2: R24.1, R29.1; also elsewhere on the board
CV3: R23.1, R28.1; also elsewhere on the board
CV4: R34.1, R42.1; also elsewhere on the board
CV5: R60.1, R64.1; also elsewhere on the board
CV6: R53.1, R57.1; also elsewhere on the board
CV7: R52.1, R56.1; also elsewhere on the board
CV8: R59.1, R63.1; also elsewhere on the board
DAC1: R44.2, U8.4 (VOUTA)
DAC2: R25.2, U8.13 (VOUTB)
DAC3: R22.2, U8.5 (VOUTC)
DAC4: R41.2, U8.12 (VOUTD)
DAC5: R65.2, U8.6 (VOUTE)
DAC6: R54.2, U8.11 (VOUTF)
DAC7: R51.2, U8.7 (VOUTG)
DAC8: R62.2, U8.10 (VOUTH)
DAC_MOSI: U8.15 (DIN); also elsewhere on the board
DAC_SCK: U8.16 (SCLK); also elsewhere on the board
DAC_SYNC: U8.2 (~SYNC); also elsewhere on the board
unnamed: C11.1, R23.2, U4.8
unnamed: C11.2, R22.1, R28.2, U4.9 (-)
unnamed: C12.1, R24.2, U4.7
unnamed: C12.2, R25.1, R29.2, U4.6 (-)
unnamed: C15.1, R42.2, U4.14
unnamed: C15.2, R34.2, R41.1, U4.13 (-)
unnamed: C16.1, R43.2, U4.1
unnamed: C16.2, R35.2, R44.1, U4.2 (-)
unnamed: C26.1, C27.1, R48.1, U8.8 (VREF)
unnamed: C33.1, R52.2, U15.8
unnamed: C33.2, R51.1, R56.2, U15.9 (-)
unnamed: C34.1, R53.2, U15.7
unnamed: C34.2, R54.1, R57.2, U15.6 (-)
unnamed: C37.1, R63.2, U15.14
unnamed: C37.2, R59.2, R62.1, U15.13 (-)
unnamed: C38.1, R64.2, U15.1
unnamed: C38.2, R60.2, R65.1, U15.2 (-)

Notes on the sheet:
CV OUTPUT BUFFERS
DIGITAL TO ANALOG CONVERTER
Inverting opamp configuration, Input range [0V,3.3V], Output range [5.17V,-5.25V]

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
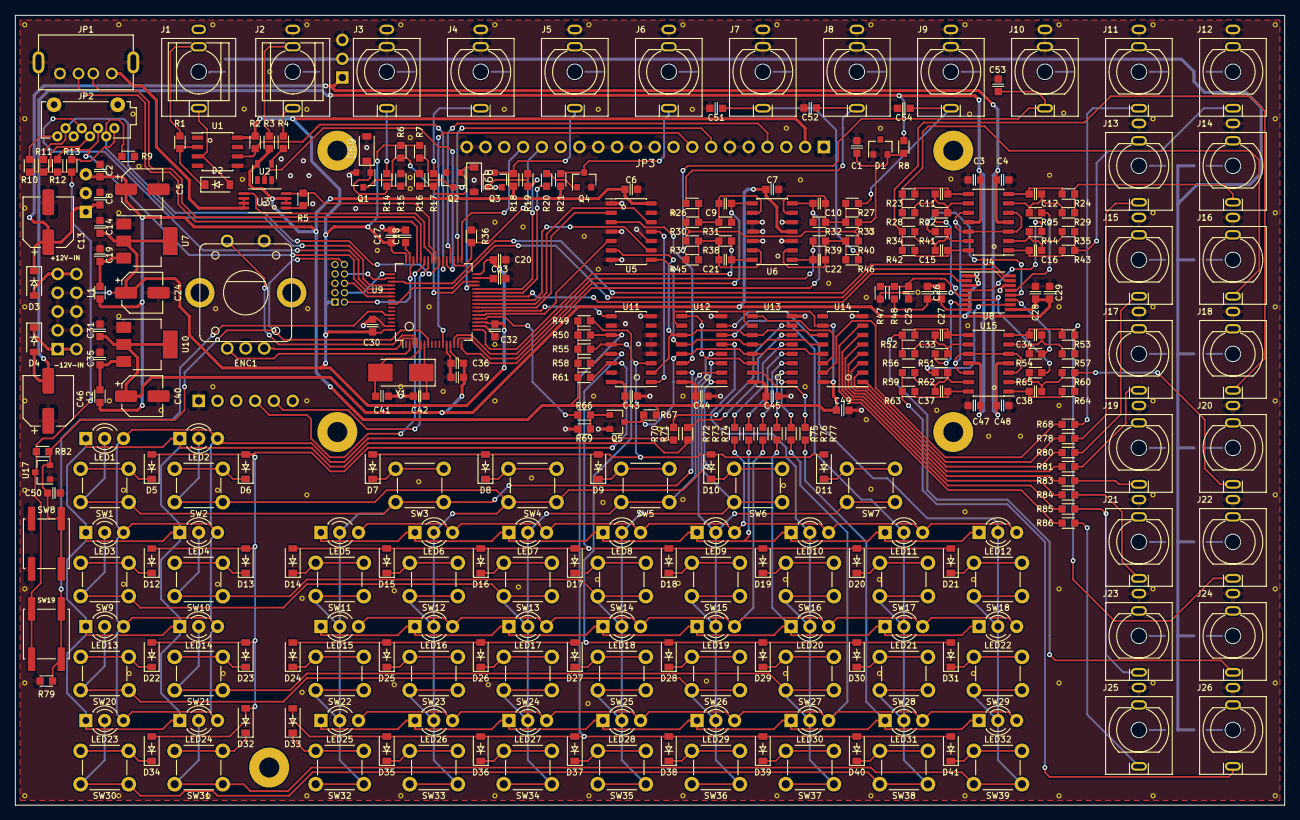
[picture p7: board sequencer.kicad_pcb from above]

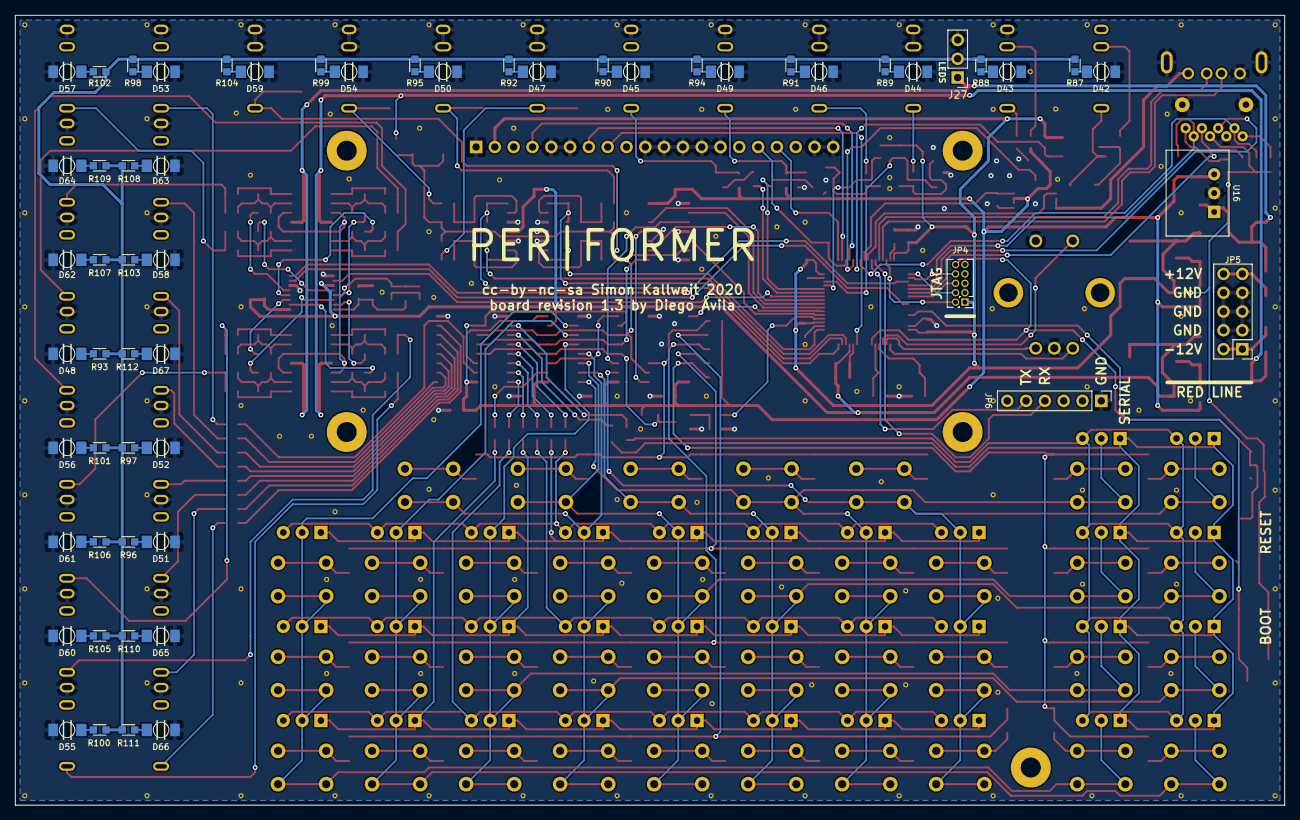
[picture p8: board sequencer.kicad_pcb from below]

Board: 2 copper layers, 171.4 x 106.7 mm, 365 parts (57 on the bottom side), 234 nets.
