dlavila/performer-hardware/(commit log)

2019-04-08 fixed feedback capacitors
    [dac.sch]
2019-04-08 replaced jacks with thonkiconns, updated pcb routing
    [sequencer.kicad_pcb]
2019-04-08 updated footprints
    [global.sch, jacks.sch]
2019-04-08 moved usb connector up
    [sequencer.kicad_pcb]
2019-04-08 updated component values and revision
    [button-matrix.sch, dac.sch, global.sch, jacks.sch, led-matrix.sch, mcu.sch, power.sch, sequencer.kicad_pcb]
2020-06-25 add voltage supervisor, add leds to jacks, update footprints
    [button-matrix.sch, dac.sch, global.sch, jacks.sch, led-matrix.sch, mcu.sch, power.sch, sequencer.kicad_pcb]
2020-09-04 small changes
    [dac.sch, frontpanel.kicad_pcb, jacks.sch, mcu.sch, power.sch, sequencer.kicad_pcb]
