dlavila/performer-hardware/(notices)

Notices in the files:
power.sch:
cc-by-nc-sa
sequencer.kicad_pcb:
cc-by-nc-sa Simon Kallweit 2020
